redt1de/CarCANdy/DOC/teensy-4.1-pinout.webp

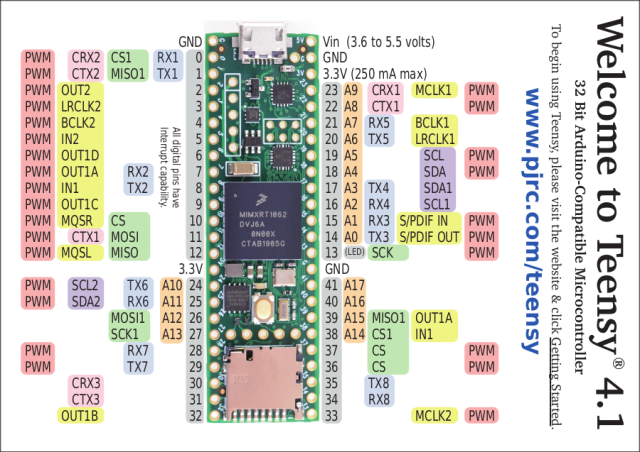
DOC/teensy-4.1-pinout.webp
