redt1de/CarCANdy/Hardware/CarCANdy-PCB/DOC/esp32-can-shield-v1.3b-all-parts-e1739144618402.png

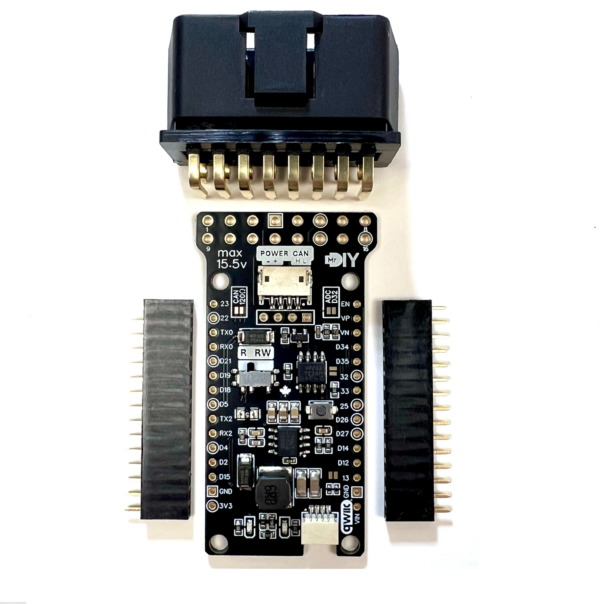
Hardware/CarCANdy-PCB/DOC/esp32-can-shield-v1.3b-all-parts-e1739144618402.png
