redt1de/CarCANdy/DOC/README.md

# DOC

Project notes, wiring, and design references.

- [architecture.md](architecture.md) — component/data-flow overview
- [pinout.md](pinout.md) — wiring/pinout reference (fill in against actual build)
- [protocol.md](protocol.md) — Teensy <-> ESP32 wire protocol (`Firmware/Shared/Packet.h`)
- [open-risks.md](open-risks.md) — known unresolved technical risks
- [config.example.json](config.example.json) — reference Teensy config schema
