redt1de/CarCANdy/DOC/protocol.md

# Teensy <-> ESP32 Protocol

Defined in [`Firmware/Shared/Packet.h`](../Firmware/Shared/Packet.h) and
[`Firmware/Shared/CanTypes.h`](../Firmware/Shared/CanTypes.h).

## Frame format

```
[sync: uint8 = 0xAA][type: uint8][length: uint16][payload: uint8[length]][crc8: uint8]
```

`crc8` is computed over `type + length + payload[0..length)`.

## Message types (`MsgType`)

| Type | Direction | Purpose |
|---|---|---|
| PING | either | liveness check |
| ACK / NACK  | either | acknowledge / reject a prior message |
| CMD | ESP32 -> Teensy  | generic command -- currently used for filter control (see below); ACK/NACK reply |
| CONFIG_GET  | ESP32 -> Teensy  | request current config |
| CONFIG_SET  | ESP32 -> Teensy  | apply new config (JSON bytes as payload) |
| CONFIG_DATA | Teensy -> ESP32  | config JSON bytes, reply to CONFIG_GET |
| CAN_FRAME | either | Teensy -> ESP32: a frame received off the bus. ESP32 -> Teensy: a frame to transmit, subject to `CANManager::sendFrame()`'s per-bus enabled/mode check (ACK/NACK reply) |
| LOG_LINE | Teensy -> ESP32  | one line of Logging's non-CAN-frame output, for the WebUI's Logging page |
| STATUS | Teensy -> ESP32  | periodic health/status blob (`CarCANdy::StatusInfo` in `Firmware/Shared/CanTypes.h`), currently just `sdReady` |

The Teensy-side dispatch lives in `Firmware/Teensy/src/CommManager.cpp`. The ESP32
side (`Firmware/ESP32/src/CommManager.cpp`) sends `CONFIG_GET` on a retry loop until
the Teensy answers (caching the JSON for `GET /api/config`), forwards
`POST /api/config` as `CONFIG_SET` and `POST /api/can/send` as a `CAN_FRAME`
transmit request (both fire-and-forget -- see below), and forwards inbound
`CAN_FRAME`/`LOG_LINE` out to WebSocket clients via callbacks. `STATUS` is
sent by `Firmware/Teensy/src/CommManager.cpp::sendStatus()` every 2s once its
`CommClient` is up; the ESP32 side just caches the latest value (no history)
and serves it via `GET /api/status`.

`LOG_LINE` is produced by `Logging::write()` (Teensy) calling a line
callback wired up in `Firmware/Teensy/src/main.cpp` -- every complete
print()/println()/printf() call Logging makes gets forwarded this way
(mirroring whatever would also go to `/log/debug_NN.log` if debug logging is
enabled on SD, but independent of that setting -- this stream works even
with SD debug logging off). `logCanFrame()` deliberately bypasses `write()`
so CAN frames are never sent as LOG_LINE packets.

### CMD grammar

`CMD`'s payload is an ASCII string (case-sensitive), parsed by
`Firmware/Teensy/src/CommManager.cpp::handleCmd()`. Currently used entirely for
filter control (see `Firmware/Teensy/include/FilterManager.h` and the filtering
design discussion):

| Command | Effect |
|---|---|
| `RELOAD_FILTERS` | Re-reads the filter CSV from SD (picks up hand-edits without a reflash) |
| `SET_FILTER_OVERRIDE:<mode>` | `mode` = `allow`\|`deny`\|`none`\|`clear`. Runtime-only, **not** persisted to `config.json` -- `clear` reverts to the configured mode. This is what the WebUI Sniffer tab's "show everything" toggle uses, so you can temporarily see unfiltered traffic without touching the saved filter mode. |
| `ADD_FILTER:<bus>,<id>` or `<bus>,<idStart>-<idEnd>` | Adds an entry and persists it to the filter CSV immediately |
| `REMOVE_FILTER:<bus>,<id>` or `<bus>,<idStart>-<idEnd>` | Removes a matching entry and persists the change |

IDs may be decimal or `0x`-prefixed hex. The ESP32 forwards these verbatim
via `CommManager::sendCmd()` / `POST /api/cmd` (`{"cmd": "..."}`) -- it has
no idea what the strings mean, it's purely a passthrough.

### Fire-and-forget requests (no reply correlation yet)

Neither side's protocol includes a request ID, so `sendConfigSet()` and
`sendCanFrame()` on the ESP32 don't wait for or correlate the Teensy's
ACK/NACK back to the HTTP request that triggered them -- the HTTP response
just confirms the packet was queued for send, not that the Teensy accepted
it. For `CONFIG_SET`, the ESP32 re-requests `CONFIG_GET` ~500ms later so
`GET /api/config` catches up either way. A NACK (e.g. a rejected transmit
because the target bus is `read_only`) is logged on the ESP32's debug
`Serial` (USB)
but not (yet) surfaced back to the web client -- worth adding request IDs
and a real response if that silence turns out to be confusing in practice.

## Transport-specific framing notes

- **UART** is a continuous byte stream. The receiver must scan for `sync`,
  tentatively read `type` + `length`, then validate `crc8` before trusting the
  frame — `0xAA` can legitimately appear inside real CAN payload bytes, so a
  single matching sync byte is not proof of a real frame boundary (false-sync
  risk). `CarCANdy::PacketStreamParser` (in `Firmware/Shared/Packet.h`) implements this
  as a byte-at-a-time state machine: on a CRC mismatch it resets to scanning
  for the next sync byte rather than assuming the whole link desynced. Both
  the Teensy's and the ESP32's `UARTClient` feed it and queue up to 8
  completed packets so a burst arriving between `poll()` calls isn't dropped
  (a 9th packet before `CommManager` drains the queue is dropped and logged;
  neither side retries on a dropped/missing reply yet, since there's no
  request ID to retry against -- see the fire-and-forget note below).
- **SPI** is paused by choice for now (UART is fast enough so far -- see
  [open-risks.md](open-risks.md) #1); when it resumes: transaction-based, the
  ESP32 (master) initiates fixed-size transfers, so there's no
  continuous-stream resync problem — `length` just says how much of the
  transfer is valid payload. The Teensy (slave) uses a dedicated DRDY GPIO
  line to tell the ESP32 when a frame is queued, since SPI slaves cannot push
  data unsolicited.

## Known limitation

`PACKET_MAX_PAYLOAD` is 1024 bytes (bumped from 512 once the config schema's
actual size, ~505 bytes with the current plugin set, left the old limit
almost no headroom — see `DOC/config.example.json`). If the config schema
grows a lot further (many more plugins/settings), it could still exceed
this — see [open-risks.md](open-risks.md) for that discussion and the
other options considered (fragmentation, section-scoped config requests,
MessagePack). `ConfigManager::toJson()`/`CommManager` treat "doesn't fit"
as an explicit failure (NACK) rather than corrupting data, but real
fragmentation/chunking across multiple packets is still not implemented.

## Endianness / struct layout

Both Teensy 4.1 (Cortex-M7) and ESP32 (Xtensa LX6) are little-endian
GCC-based toolchains, and all wire structs use `#pragma pack(push, 1)`, so raw
struct-to-struct memcpy across the link is safe. This assumption would break
if a big-endian target were ever added to the project.
