redt1de/CarCANdy/CarCANdy-PCB/DOC/notes.md

D1  - reverse-polarity protection use SS16 / SS26 / B160 / B260 Schottky -> SS26 — 2A, 60V Schottky
D2 - flyback diode, use B340A Shottky diode

The RS pin (pin 8) on the SN65HVD233 CAN transceiver selects between three operating modes:
 - High-Speed Mode: Tie to ground (0 V) for maximum transmission speed with no slew-rate limits.
 - Slope Control: Connect a resistor to ground (e.g., 10 kΩ to 100 kΩ) to limit signal rise/fall times, reducing electromagnetic interference (EMI).
 - Standby Mode: Apply a high logic level (near \(V_{CC}\)) to enter a low-current state; the transmitter turns off, but the receiver remains active to detect bus wake-up
