redt1de/CarCANdy/DOC/CAN_RESEARCH/CAN.md

I would like to create a JSON file that will act as a database I can use to lookup/track CAN IDs and values specific to my 2015 Ford Mustang GT. I will eventually make use of this data in CarCANDY but for now I just want to create the database. Please analyze the following sources and organize all the can ids in a way that can be used to decode data logged with CarCANdy. I created a new folder ./DOC/CANDB where we can store various databases for different cars. For now lets just create one for my 2015 Ford Mustang GT

# forum post has a table with some CAN ID information
https://www.mustang6g.com/forums/threads/some-results-of-can-research.176383/

# github projects with CAN IDs for a 2015 ford mutang
https://github.com/v-ivanyshyn/parse_can_logs/blob/master/Ford%20CAN%20IDs%20Summary.md
https://github.com/EricTurner3/s550-canbus/blob/master/database.md
