redt1de/CarCANdy/CarCANdy-PCB-v2/DOC/esp32-can-shield-v1.3b-front-e1739144674632.png

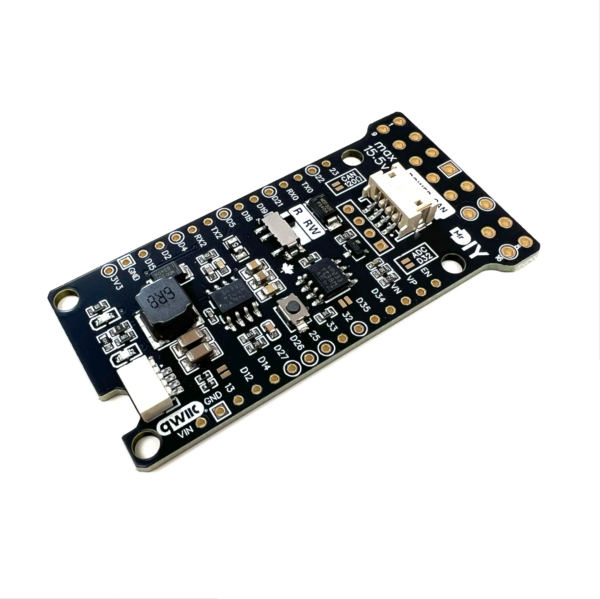
CarCANdy-PCB-v2/DOC/esp32-can-shield-v1.3b-front-e1739144674632.png
