redt1de/CarCANdy/CarCANdy-PCB-v2/DOC/pcb_can_shield_esp32_v1.1.png

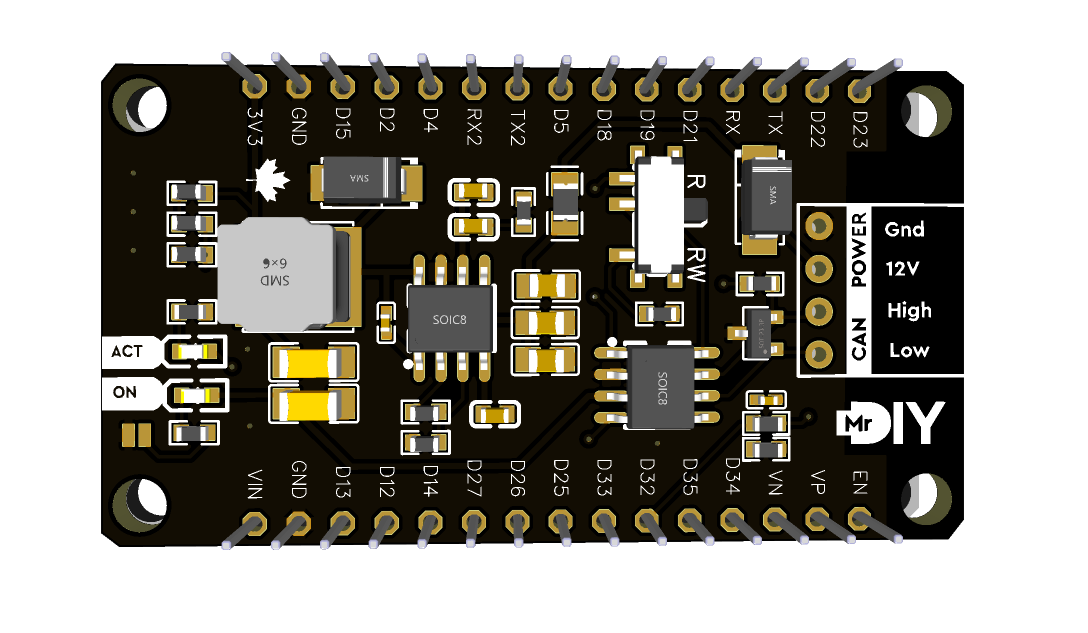
CarCANdy-PCB-v2/DOC/pcb_can_shield_esp32_v1.1.png
