redt1de/CarCANdy/DOC/ESP32-S3-Mini_pinout.jpg

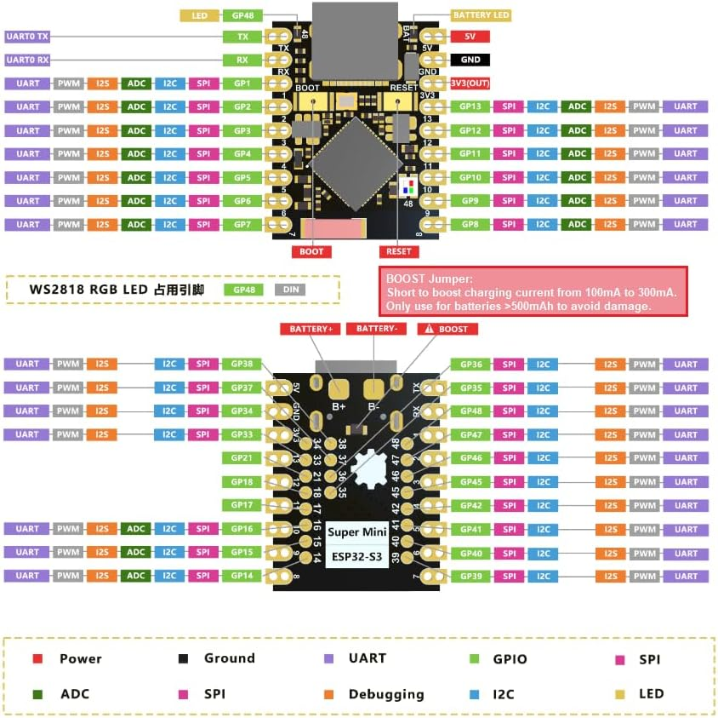
DOC/ESP32-S3-Mini_pinout.jpg
