redt1de/CarCANdy/DOC/RJ45-Pinout-T568A.jpg

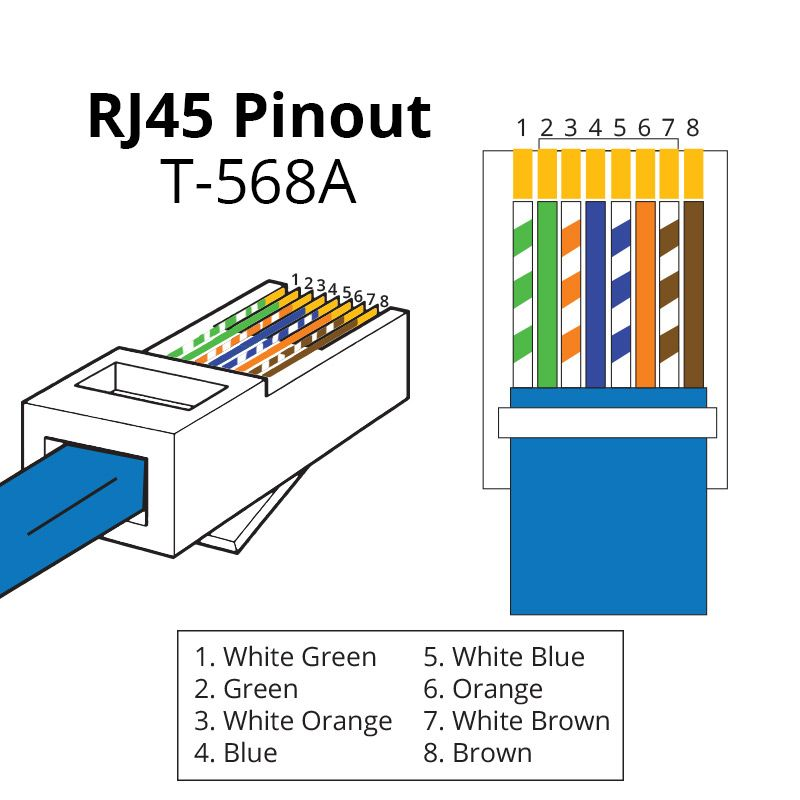
DOC/RJ45-Pinout-T568A.jpg
