redt1de/CarCANdy/Hardware/CarCANdy-PCB/DOC/pcb-io-backup.png

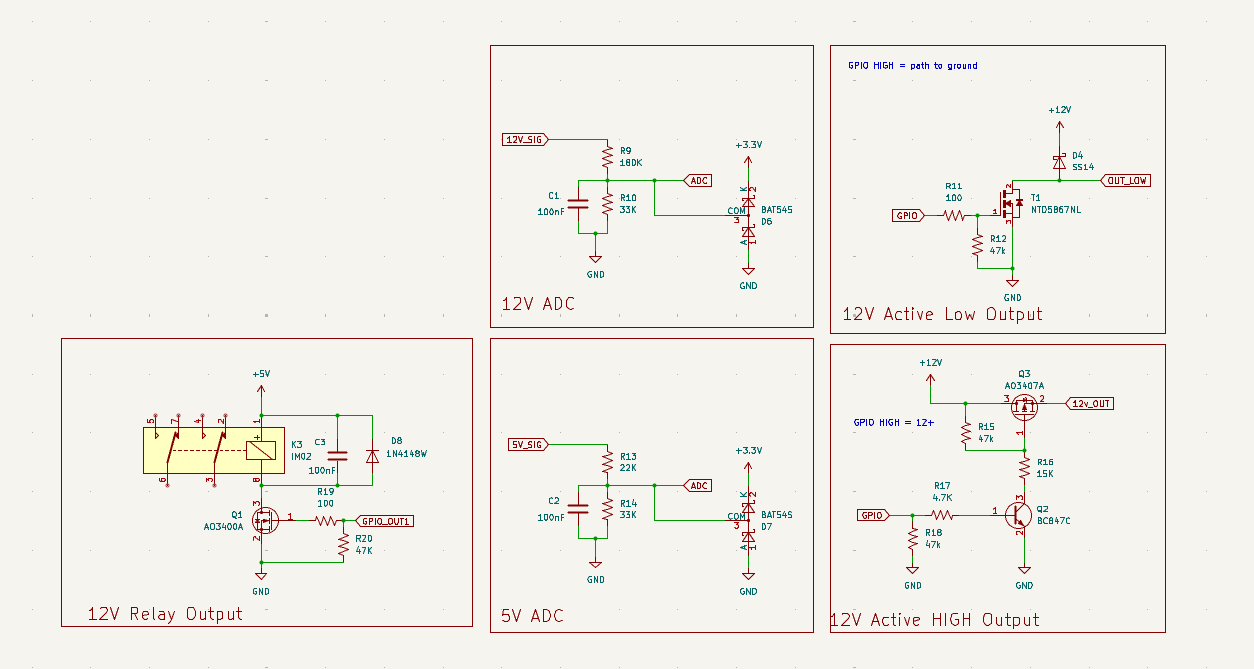
Hardware/CarCANdy-PCB/DOC/pcb-io-backup.png
