redt1de/CarCANdy/CarCANdy-PCB/shopping-list.txt

# ICs
*x3 NUP2105LT1G SOT23-3
*x6 1N4148W D_SOD-123
*x2 BAT54S SOT-23
*x3 SN65HVD233DR SOIC127P599X175-8N
*x3 IM02 RELAY_IM02TS (1-1462038-2 is parametric replacement, non bulk)
*x3 AO3400A SOT-23
*x3 LTV-357T 4-SOP
*x3 JS202011CQN JS202011CQN (digikey alternative CL-SB-22C-02 cause its 12V)

# Connectors
!x1 8P8C_Shielded RJ45_RCH_RC01937 (https://www.amazon.com/FMHXG-Shielded-Network-Connector-Computer/dp/B0BRQ2R8HW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)
!x1 Power JST_VH_S2P-VH_1x02_P3.96mm_Horizontal (https://www.amazon.com/pzsmocn-JST-VH-SMT-Housing-Connector-Terminal/dp/B089QR8G2D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)
!x3 Relays JST_VH_S3P-VH_1x03_P3.96mm_Horizontal (https://www.amazon.com/pzsmocn-JST-VH-SMT-Housing-Connector-Terminal/dp/B08F53M49D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)
!x6 3-pin 2.00mm pitch pin headers with jumpers (amazon)
!x2 Aux JST_PH_S4B-PH-K_1x04_P2.00mm_Horizontal  (https://www.amazon.com/Socket-Compatible-JST-PH-Connectors-Through-Hole/dp/B0BM492MMF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)
!x2 ADCs JST_EH_S3B-EH_1x03_P2.50mm_Horizontal (https://www.amazon.com/sspa/click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)
!x3 Inputs JST_EH_S2B-EH_1x02_P2.50mm_Horizontal (^^ above kit ^^)

# Caps and Resistors
x3 120 R_0603_1608Metric_Pad0.98x0.95mm_HandSolder
x3 10K R_0603_1608Metric_Pad0.98x0.95mm_HandSolder
x3 2.2K R_0603_1608Metric_Pad0.98x0.95mm_HandSolder
x3 10k R_0603_1608Metric_Pad0.98x0.95mm_HandSolder
x2 22K R_0603_1608Metric_Pad0.98x0.95mm_HandSolder
x2 33K R_0603_1608Metric_Pad0.98x0.95mm_HandSolder
x3 100 R_0603_1608Metric_Pad0.98x0.95mm_HandSolder
x3 47K R_0603_1608Metric_Pad0.98x0.95mm_HandSolder
x5 100nF 0603 Capacitor (https://www.amazon.com/Cermant-Capacitor-Assorted-3-9pF-22uF-Electronic/dp/B09V9XH6YL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)

# Misc
*x1 ESP32-C3_SUPERMINI_TH MODULE_ESP32-C3_SUPERMINI_TH (amazon)
*x1 Teensy4.1 Teensy41 (amazon)
*x1 12v-5v_mini_buck mini12v-5v_buck (amazon)

x -0.018
y -0.629
