redt1de/CarCANdy/DOC/parts.md

NTD5867NLT4G - MOSFET
sn65hvd233 - CAN Transiever
nup2105lt1g - TVS Diode
1-1462038-6/IM06 - Relay
100nF Capacitor
LTV-817S-TA - optocoupler
