redt1de/CarCANdy/Hardware/CarCANdy-PCB/pcbway_production/2026-07-21-17-01-40/CarCANdy-PCB.kicad_pcb_bom.csv

Designator | Quantity | Value | Footprint | Package | MPN | DNP | Mount_Type | Description | KiLib_Generator | MF | MAXIMUM_PACKAGE_HEIGHT | Price | Check_prices | STANDARD | PARTREV | SnapEDA_Link | MP | MANUFACTURER | Availability | SNAPEDA_PN | Sim.Device | Sim.Pins | CREATOR
C2, C3, C4, C5, C6 | 5 | 100nF | C_0603_1608Metric_Pad1.08x0.95mm_HandSolder |  |  |  | smt | Unpolarized capacitor | SMD_2terminal_chip_molded
D1, D2, D3 | 3 | NUP2105LT1G | SOT-23-3 | SOT-23-3 ON Semiconductor |  |  | smt | Dual Bi-Directional TVS Diode 350W 3-Pin SOT-23 | ON Semiconductor NUP2105LT1G | package/gullwing | ON Semiconductor | 1.11mm | None | https://www.snapeda.com/parts/NUP2105LT1G/Onsemi/view-part/?ref=eda | IPC-7351B | 10 | https://www.snapeda.com/parts/NUP2105LT1G/Onsemi/view-part/?ref=snap | NUP2105LT1G | Onsemi | In Stock | NUP2105LT1G
D10, D11, D12, D5, D8, D9 | 6 | 1N4148W | D_SOD-123 |  |  |  | smt | 75V 0.15A Fast Switching Diode, SOD-123 |  |  |  |  |  |  |  |  |  |  |  |  | D | 1=K 2=A
D13, D7 | 2 | BAT54S | SOT-23 |  |  |  | smt | Vr 30V, If 200mA, Dual schottky barrier diode, in series, SOT-323 | package/gullwing
J1 | 1 | 8P8C_Shielded | RJ45_RCH_RC01937 |  |  |  | tht | RJ connector, 8P8C (8 positions 8 connected), RJ31/RJ32/RJ33/RJ34/RJ35/RJ41/RJ45/RJ49/RJ61, Shielded
J10, J11 | 2 | ADC1 | JST_XH_S3B-XH-A-1_1x03_P2.50mm_Horizontal |  |  |  | tht | Generic connector, single row, 01x03, script generated | connector/JST
J13, J14, J15 | 3 | Conn_01x02_Pin | JST_XH_S2B-XH-A-1_1x02_P2.50mm_Horizontal |  |  |  | tht | Generic connector, single row, 01x02, script generated | connector/JST
J2 | 1 | Power | JST_VH_S2P-VH_1x02_P3.96mm_Horizontal |  |  |  | tht | Generic connector, single row, 01x02, script generated | connector/JST
J4, J8 | 2 | AUART1 | JST_XH_S4B-XH-A-1_1x04_P2.50mm_Horizontal |  |  |  | tht | Generic connector, single row, 01x04, script generated | connector/JST
J5, J6, J7 | 3 | JSTVH3 | JST_VH_S3P-VH_1x03_P3.96mm_Horizontal | None |  |  | tht | 2~24 Poles, Screw Type, Horizontal, 5.08 Pitch, 24~12 (AWG), Terminal Block Connector | connector/JST | Same Sky |  | None | https://www.snapeda.com/parts/TB004-508-03BE/Same+Sky/view-part/?ref=eda | Manufacturer Recommendations |  | https://www.snapeda.com/parts/TB004-508-03BE/Same+Sky/view-part/?ref=snap | TB004-508-03BE | CUI | In Stock
K3, K4, K5 | 3 | IM02 | RELAY_IM06TS |  |  |  | tht | IM Relay, standard version, monostable, switching current 2/5A, power 60W/62.5VA, voltage 220VDC/250VAC
PSU1 | 1 | 12v-5v_mini_buck | mini12v-5v_buck |  |  |  | smt | Generic connector, single row, 01x04, script generated
Q1, Q2, Q3 | 3 | AO3400A | SOT-23 |  |  |  | smt | 30V Vds, 5.7A Id, N-Channel MOSFET, SOT-23 | package/gullwing
R1, R3, R5 | 3 | 120 | R_0603_1608Metric_Pad0.98x0.95mm_HandSolder |  |  |  | smt | Resistor, US symbol | SMD_2terminal_chip_molded
R13, R15 | 2 | 22K | R_0603_1608Metric_Pad0.98x0.95mm_HandSolder |  |  |  | smt | Resistor, US symbol | SMD_2terminal_chip_molded
R14, R16 | 2 | 33K | R_0603_1608Metric_Pad0.98x0.95mm_HandSolder |  |  |  | smt | Resistor, US symbol | SMD_2terminal_chip_molded
R19, R25, R27 | 3 | 100 | R_0603_1608Metric_Pad0.98x0.95mm_HandSolder |  |  |  | smt | Resistor, US symbol | SMD_2terminal_chip_molded
R2, R4, R6 | 3 | 10K | R_0603_1608Metric_Pad0.98x0.95mm_HandSolder |  |  |  | smt | Resistor, US symbol | SMD_2terminal_chip_molded
R20, R26, R28 | 3 | 47K | R_0603_1608Metric_Pad0.98x0.95mm_HandSolder |  |  |  | smt | Resistor, US symbol | SMD_2terminal_chip_molded
R21, R23, R7 | 3 | 2.2K | R_0603_1608Metric_Pad0.98x0.95mm_HandSolder |  |  |  | smt | Resistor, US symbol | SMD_2terminal_chip_molded
R22, R24, R8 | 3 | 10k | R_0603_1608Metric_Pad0.98x0.95mm_HandSolder |  |  |  | smt | Resistor, US symbol | SMD_2terminal_chip_molded
SW2, SW3, SW4 | 3 | JS202011CQN | JS202011CQN |  |  |  | tht | Switch, dual pole double throw, separate symbols
U1, U7, U8 | 3 | LTV-357T | SOP-4_3.8x4.1mm_P2.54mm |  |  |  | smt | DC Optocoupler, Vce 35V, CTR 50%, SO-4 | package/gullwing
U2 | 1 | ESP32-C3_SUPERMINI_TH | MODULE_ESP32-C3_SUPERMINI_TH | Package |  |  | tht | Super tiny ESP32-C3 board |  | Espressif Systems |  | None | https://www.snapeda.com/parts/ESP32-C3%20SuperMini_TH/Espressif+Systems/view-part/?ref=eda | IPC-7351B |  | https://www.snapeda.com/parts/ESP32-C3%20SuperMini_TH/Espressif+Systems/view-part/?ref=snap | ESP32-C3 SuperMini_TH | Espressif Systems | Not in stock |  |  |  | DIZAR
U3, U4, U5 | 3 | SN65HVD233DR | SOIC127P599X175-8N | SOIC-8 Texas Instruments |  |  | smt | 3.3 V CAN Transceiver with Standby Mode, Loopback |  | Texas Instruments |  | None | https://www.snapeda.com/parts/SN65HVD233DR/Texas+Instruments/view-part/?ref=eda |  |  | https://www.snapeda.com/parts/SN65HVD233DR/Texas+Instruments/view-part/?ref=snap | SN65HVD233DR |  | In Stock
U6 | 1 | Teensy4.1 | Teensy41 |  |  |  | tht
