redt1de/CarCANdy/Hardware/CarCANdy-PCB/digikey-cart.csv

Index | Quantity | Part Number | Manufacturer Part Number | Description | Customer Reference | Available | Backorder | Unit Price | Extended Price USD
1 | 3 | 296-35967-1-ND | SN65HVD233DR | IC TRANSCEIVER HALF 1/1 8SOIC |  | 3 | 0 | 3.21000 | 9.63
2 | 1 | 160-2038-1-ND | LTV-817S-TA | OPTOISOLATOR 5KV 1CH TRANS 4-SMD |  | 1 | 0 | 0.44000 | 0.44
3 | 3 | NUP2105LT1GOSCT-ND | NUP2105LT1G | TVS DIODE 24VWM 44VC SOT23-3 |  | 3 | 0 | 0.44000 | 1.32
4 | 6 | 1655-1N4148WCT-ND | 1N4148W | DIODE GEN PURP 75V 250MA SOD123 |  | 6 | 0 | 0.14000 | 0.84
5 | 2 | 4878-BAT54SCT-ND | BAT54S | DIODE ARR SCHOTT 30V 200MA SOT23 |  | 2 | 0 | 0.16000 | 0.32
6 | 3 | PB2111-ND | 1-1462038-2 | RELAY TELECOM DPDT 2A 4.5V |  | 3 | 0 | 4.71000 | 14.13
7 | 3 | 785-1000-1-ND | AO3400A | MOSFET N-CH 30V 5.7A SOT23-3L |  | 3 | 0 | 0.52000 | 1.56
8 | 3 | 160-1339-1-ND | LTV-357T | OPTOISO 3.75KV 1CH TRANS 4-SOP |  | 3 | 0 | 0.43000 | 1.29
9 | 3 | 160-1339-1-ND | LTV-357T | OPTOISO 3.75KV 1CH TRANS 4-SOP |  | 3 | 0 | 0.43000 | 1.29
10 | 3 | 401-2001-ND | JS202011CQN | SWITCH SLIDE DPDT 300MA 6V |  | 3 | 0 | 0.84000 | 2.52
11 | 3 | 563-1347-ND | CL-SB-22C-02 | SWITCH SLIDE DPDT 200MA 12V |  | 3 | 0 | 1.52000 | 4.56
