redt1de/CarCANdy/CarCANdy-PCB-v2/pcb.step

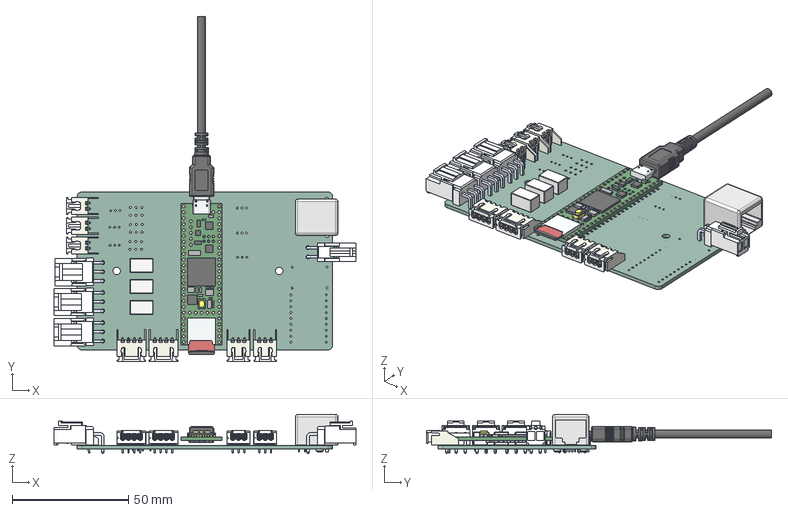
[picture p8: CAD file, 2026-10-16]
CarCANdy-PCB-v2/pcb.step
130.0 x 148.6 x 16.8 mm
JST_S4B_XH_A_1 x 2
Housing x 7
modele_pin x 20
BxPS-VH_3 x 3
pin^BxPS-VH ass x 9
VHR-3N x 3
JST_S3B_XH_A_1 x 2
BxPS-VH_5__Boss-Extrude4
pin^BxPS-VH ass__Chamfer1_2
pin^BxPS-VH ass__Chamfer1
VHR-2N
Teensy_4.1_Assembly
Cable
Micro_USB_Plug_Connector
JST_S2B_XH_A_1 x 3
CarCANdy-PCB-V2_PCB
