redt1de/CarCANdy/Hardware/CarCANdy-PCB/pcb-noplug.step

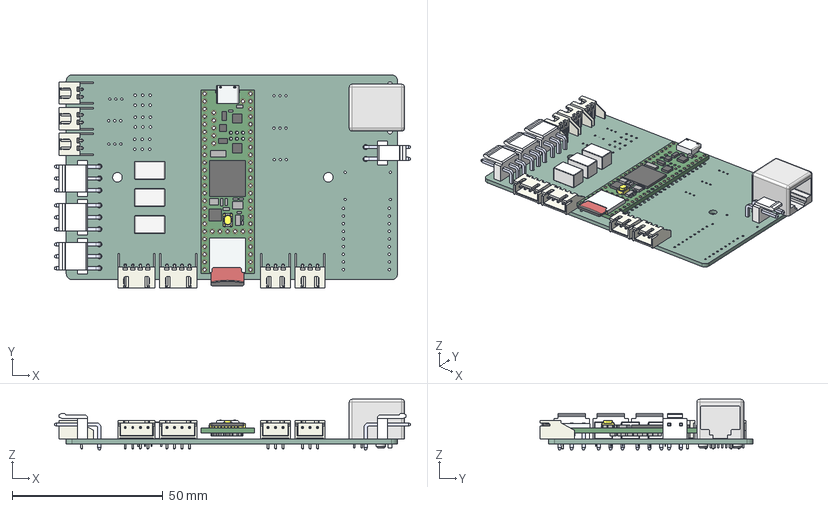
[picture p10: CAD file, 2026-10-17]
Hardware/CarCANdy-PCB/pcb-noplug.step
118.2 x 70.8 x 16.8 mm
JST_S4B_XH_A_1 x 2
BxPS-VH_3 x 3
pin^BxPS-VH ass x 9
JST_S3B_XH_A_1 x 2
BxPS-VH_5__Boss-Extrude4
pin^BxPS-VH ass__Chamfer1_2
pin^BxPS-VH ass__Chamfer1
Teensy_4.1_Assembly
JST_S2B_XH_A_1 x 3
CarCANdy-PCB_PCB
