redt1de/CarCANdy/Hardware/CarCANdy-PCB/pcb-noplug-with-headers.step

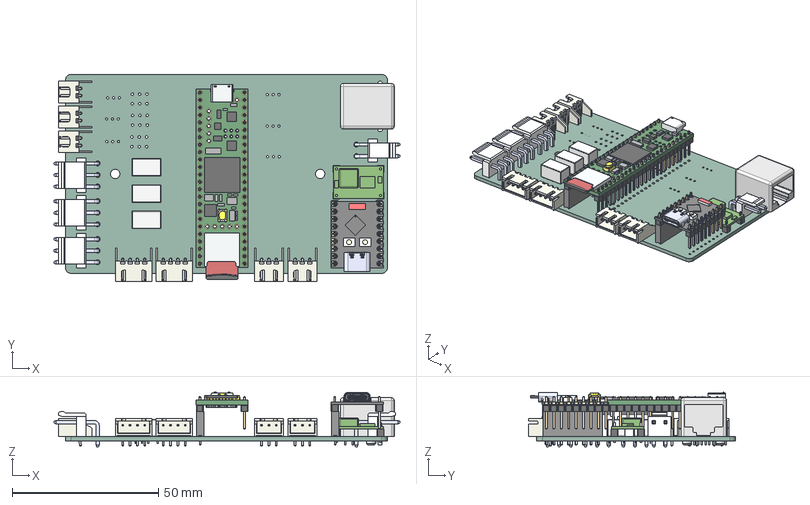
[picture p11: CAD file, 2026-10-17]
Hardware/CarCANdy-PCB/pcb-noplug-with-headers.step
118.2 x 70.8 x 18.7 mm
JST_S4B_XH_A_1 x 2
BxPS-VH_3 x 3
pin^BxPS-VH ass x 9
JST_S3B_XH_A_1 x 2
BxPS-VH_5__Boss-Extrude4
pin^BxPS-VH ass__Chamfer1_2
pin^BxPS-VH ass__Chamfer1
1_Male_Pin_2.54_mm__Chamfer5_7 x 57
FemaleHeader x 2
JST_S2B_XH_A_1 x 3
Board c3mini__Split1[4]
1_Male_Pin_2.54_mm__Chamfer5 x 9
Board c3mini__Split1[6]
Board c3mini__Split1[5]
Board c3mini__Split1[10]
Board c3mini__Split1[2]
Board c3mini__Split1[14]
components (other)^ESP32-C3 SuperMini__Boss-Extrude2
Board c3mini__Split1[7]
Board c3mini__Split1[1]
USB C__Imported1
components (other)^ESP32-C3 SuperMini__Boss-Extrude3[2]
components (other)^ESP32-C3 SuperMini__Boss-Extrude5
Board c3mini__Split1[13]
Board c3mini__Split1[9]
components (other)^ESP32-C3 SuperMini__Cut-Extrude1
components (other)^ESP32-C3 SuperMini__Boss-Extrude3[1]
Board c3mini__Split1[8]
Board c3mini__Split1[12]
Board c3mini__Split1[11]
Board c3mini__Split1[17] x 2
Board c3mini__Split1[16] x 2
components (other)^ESP32-C3 SuperMini__Boss-Extrude4[2]
components (other)^ESP32-C3 SuperMini__Boss-Extrude4[1]
Board c3mini__Split1[3]
Board c3mini__Split1[15]
CarCANdy-PCB_PCB
