redt1de/CarCANdy/CarCANdy-PCB/.step

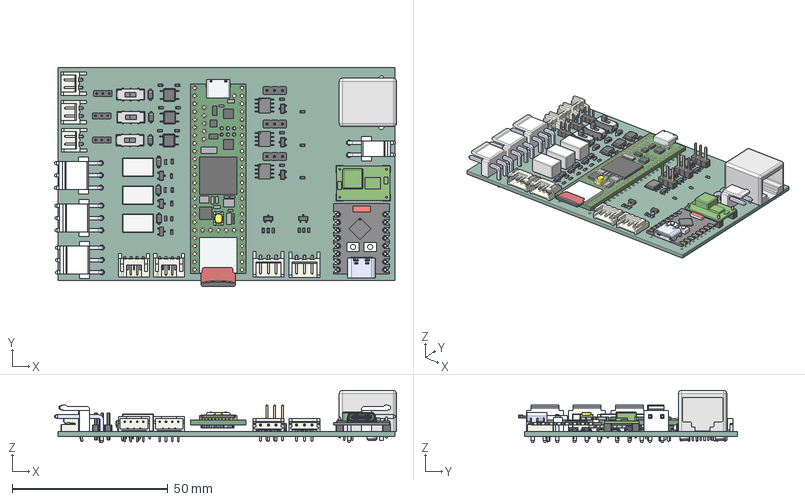
[picture p12: CAD file, 2026-07-21]
CarCANdy-PCB/.step
109.9 x 70.3 x 16.8 mm
R_0603_1608Metric x 22
JST_S4B_PH_K x 2
PinHeader_1x03_P200mm_Vertical x 3
D_SOD-123 x 6
SOT-23 x 5
BxPS-VH_3 x 3
pin^BxPS-VH ass x 9
SOT-23-3 x 3
Body001 (Mirror #1) x 12
XY-plane x 36
X-axis x 36
SOP-4_3.8x4.1mm_P2.54mm x 3
PinHeader_1x03_P254mm_Vertical x 3
JST_S3B_EH x 2
BxPS-VH_5__Boss-Extrude4
pin^BxPS-VH ass__Chamfer1_2
pin^BxPS-VH ass__Chamfer1
Teensy_4.1_Assembly
C_0603_1608Metric x 5
JS202011CQN x 3
JST_S2B_EH x 3
Board c3mini
USB C
components (other)^ESP32-C3 SuperMini
CarCANdy-PCB_PCB
