redt1de/CarCANdy/(list of files, cad)

Other CAD files:
CarCANdy-PCB-v2/pcb-noplug.step
CarCANdy-PCB/pcb.step
CarCANdy-PCB-v2/pcb-noplug-with-headers.step
Hardware/CarCANdy-PCB-v2/CarCANdy-PCB-V2.step
