redt1de/CarCANdy/DOC/claude-TODO.md

Lets clean up the documentation.  
things that need covered:

Hardware:
- teensy pinout
- RJ45 pinout
- aux port pinouts
- input usage (jumpers and switches)
- output usage
- ADC usage
- CAN bus jumpers

Config/Software:
- config.json
- filters.json
