redt1de/CarCANdy/DOC/TODO.md

TODO

## WebUI changes
- sniffer page should have send capabilities.
