redt1de/CarCANdy/CarCANdy-PCB/CarCANdy-PCB.kicad_pcb

## KiCad design CarCANdy-PCB/CarCANdy-PCB.kicad_pcb (2026-08-25)

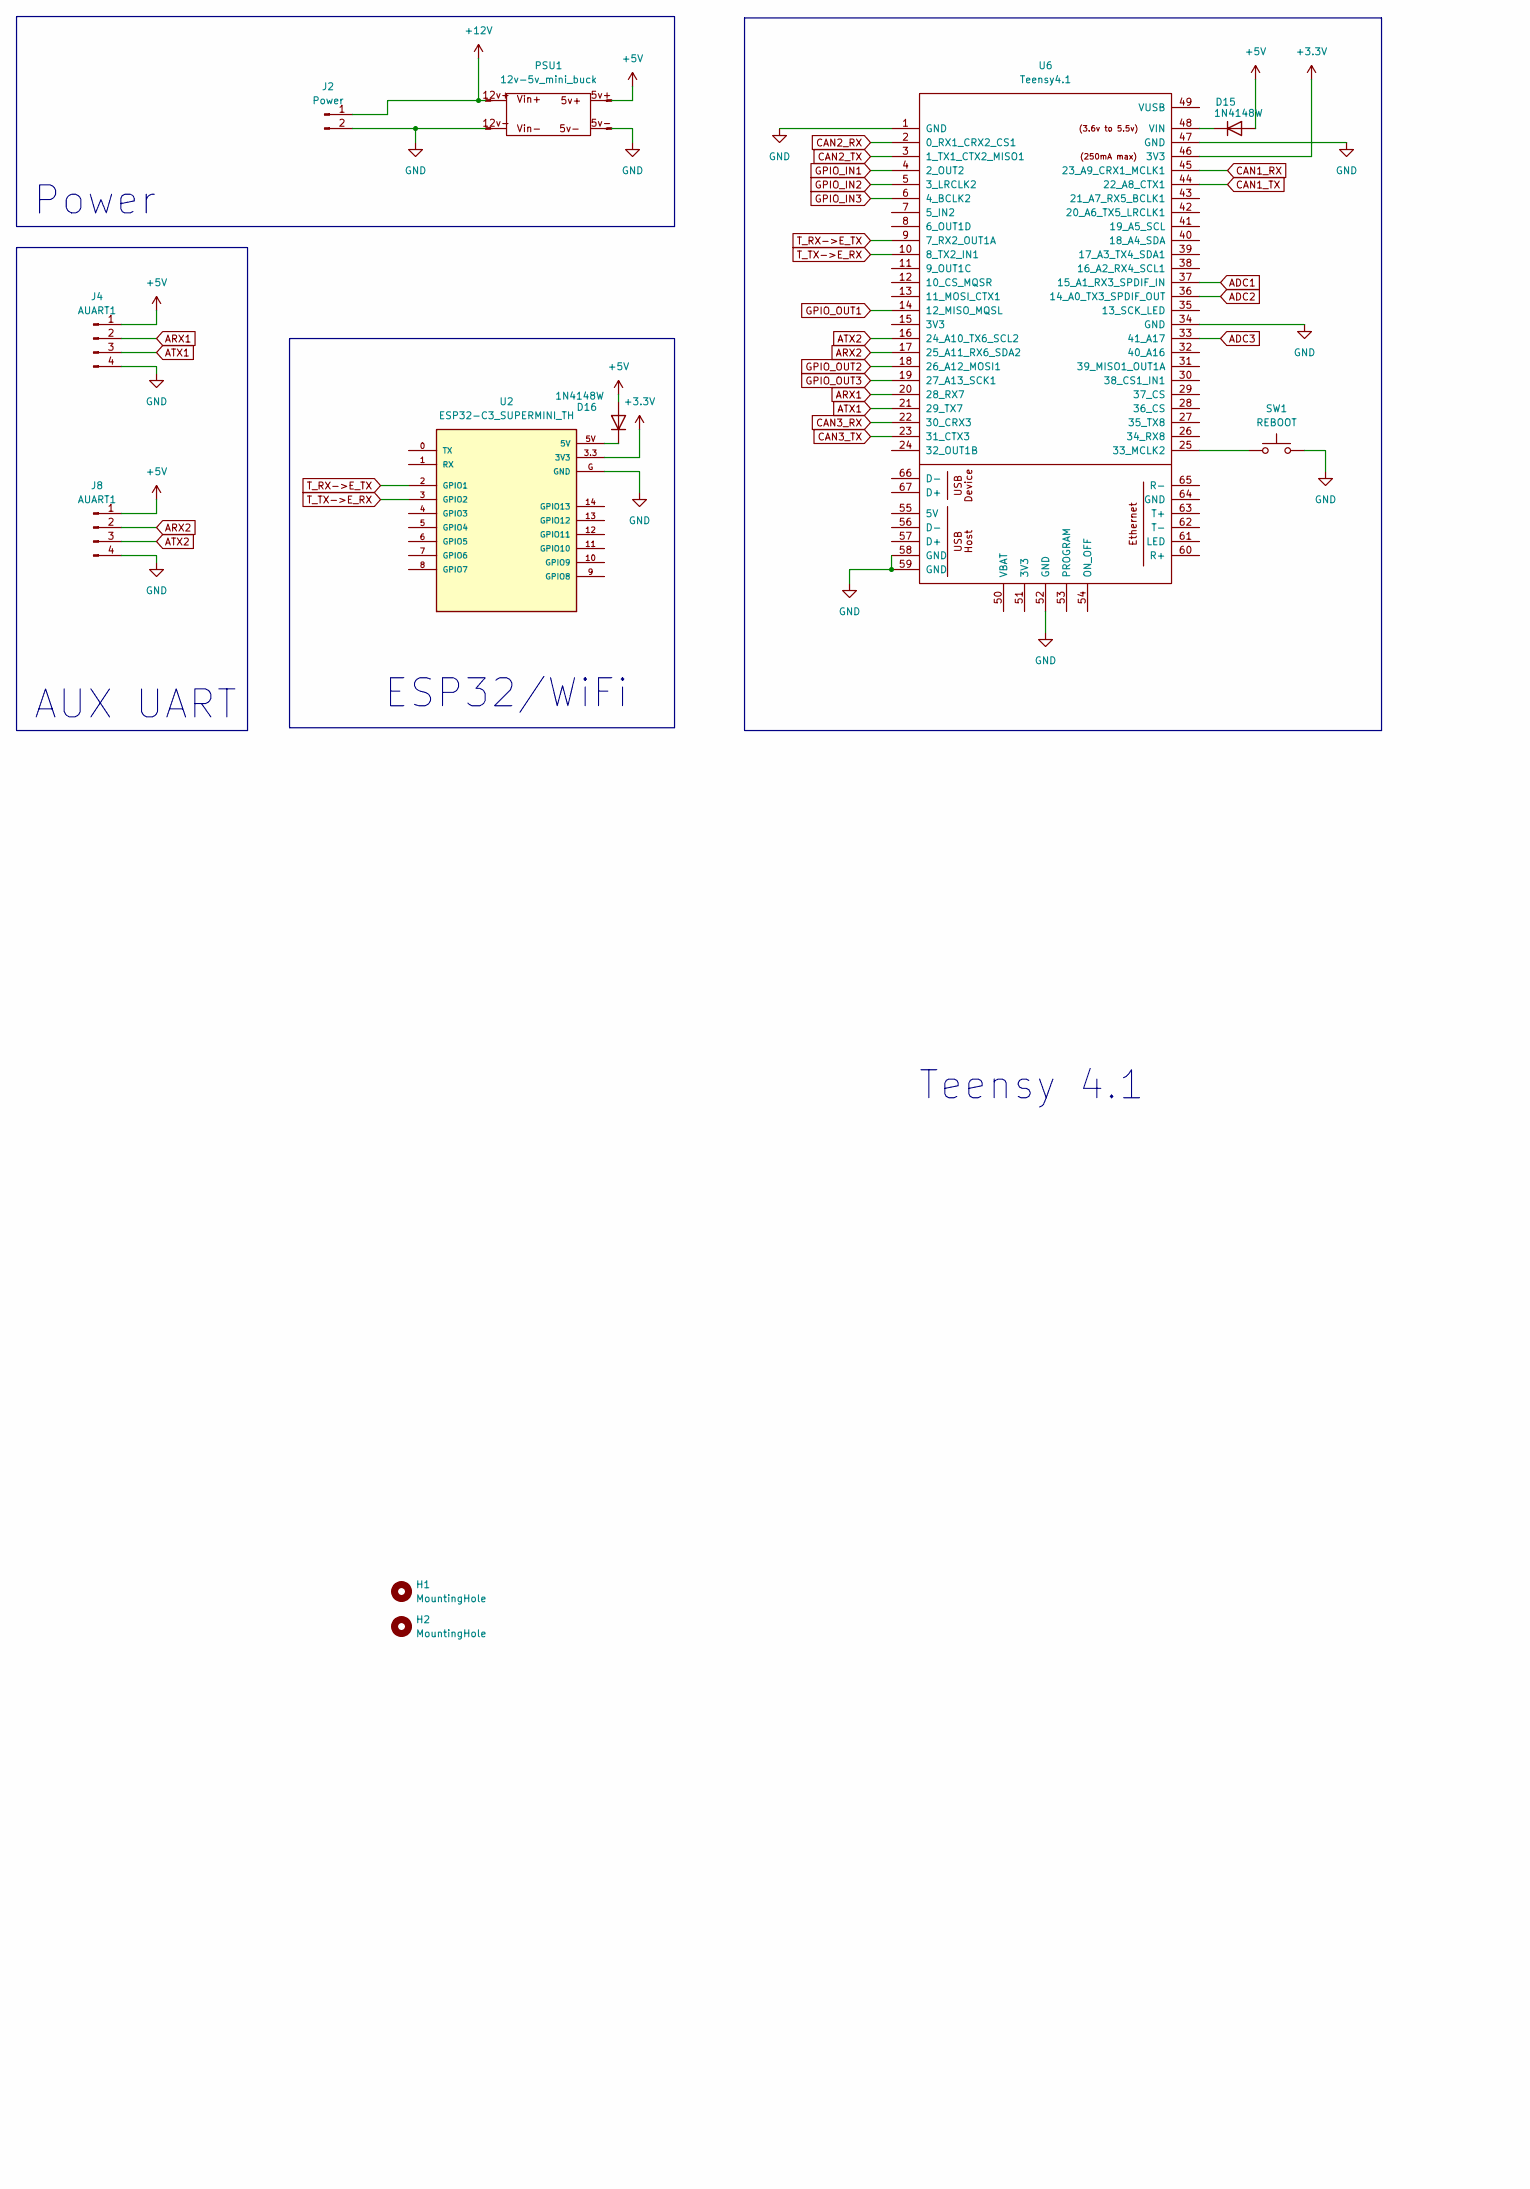
[picture p13: schematic CarCANdy-PCB.kicad_sch, part in row 1, column 1]

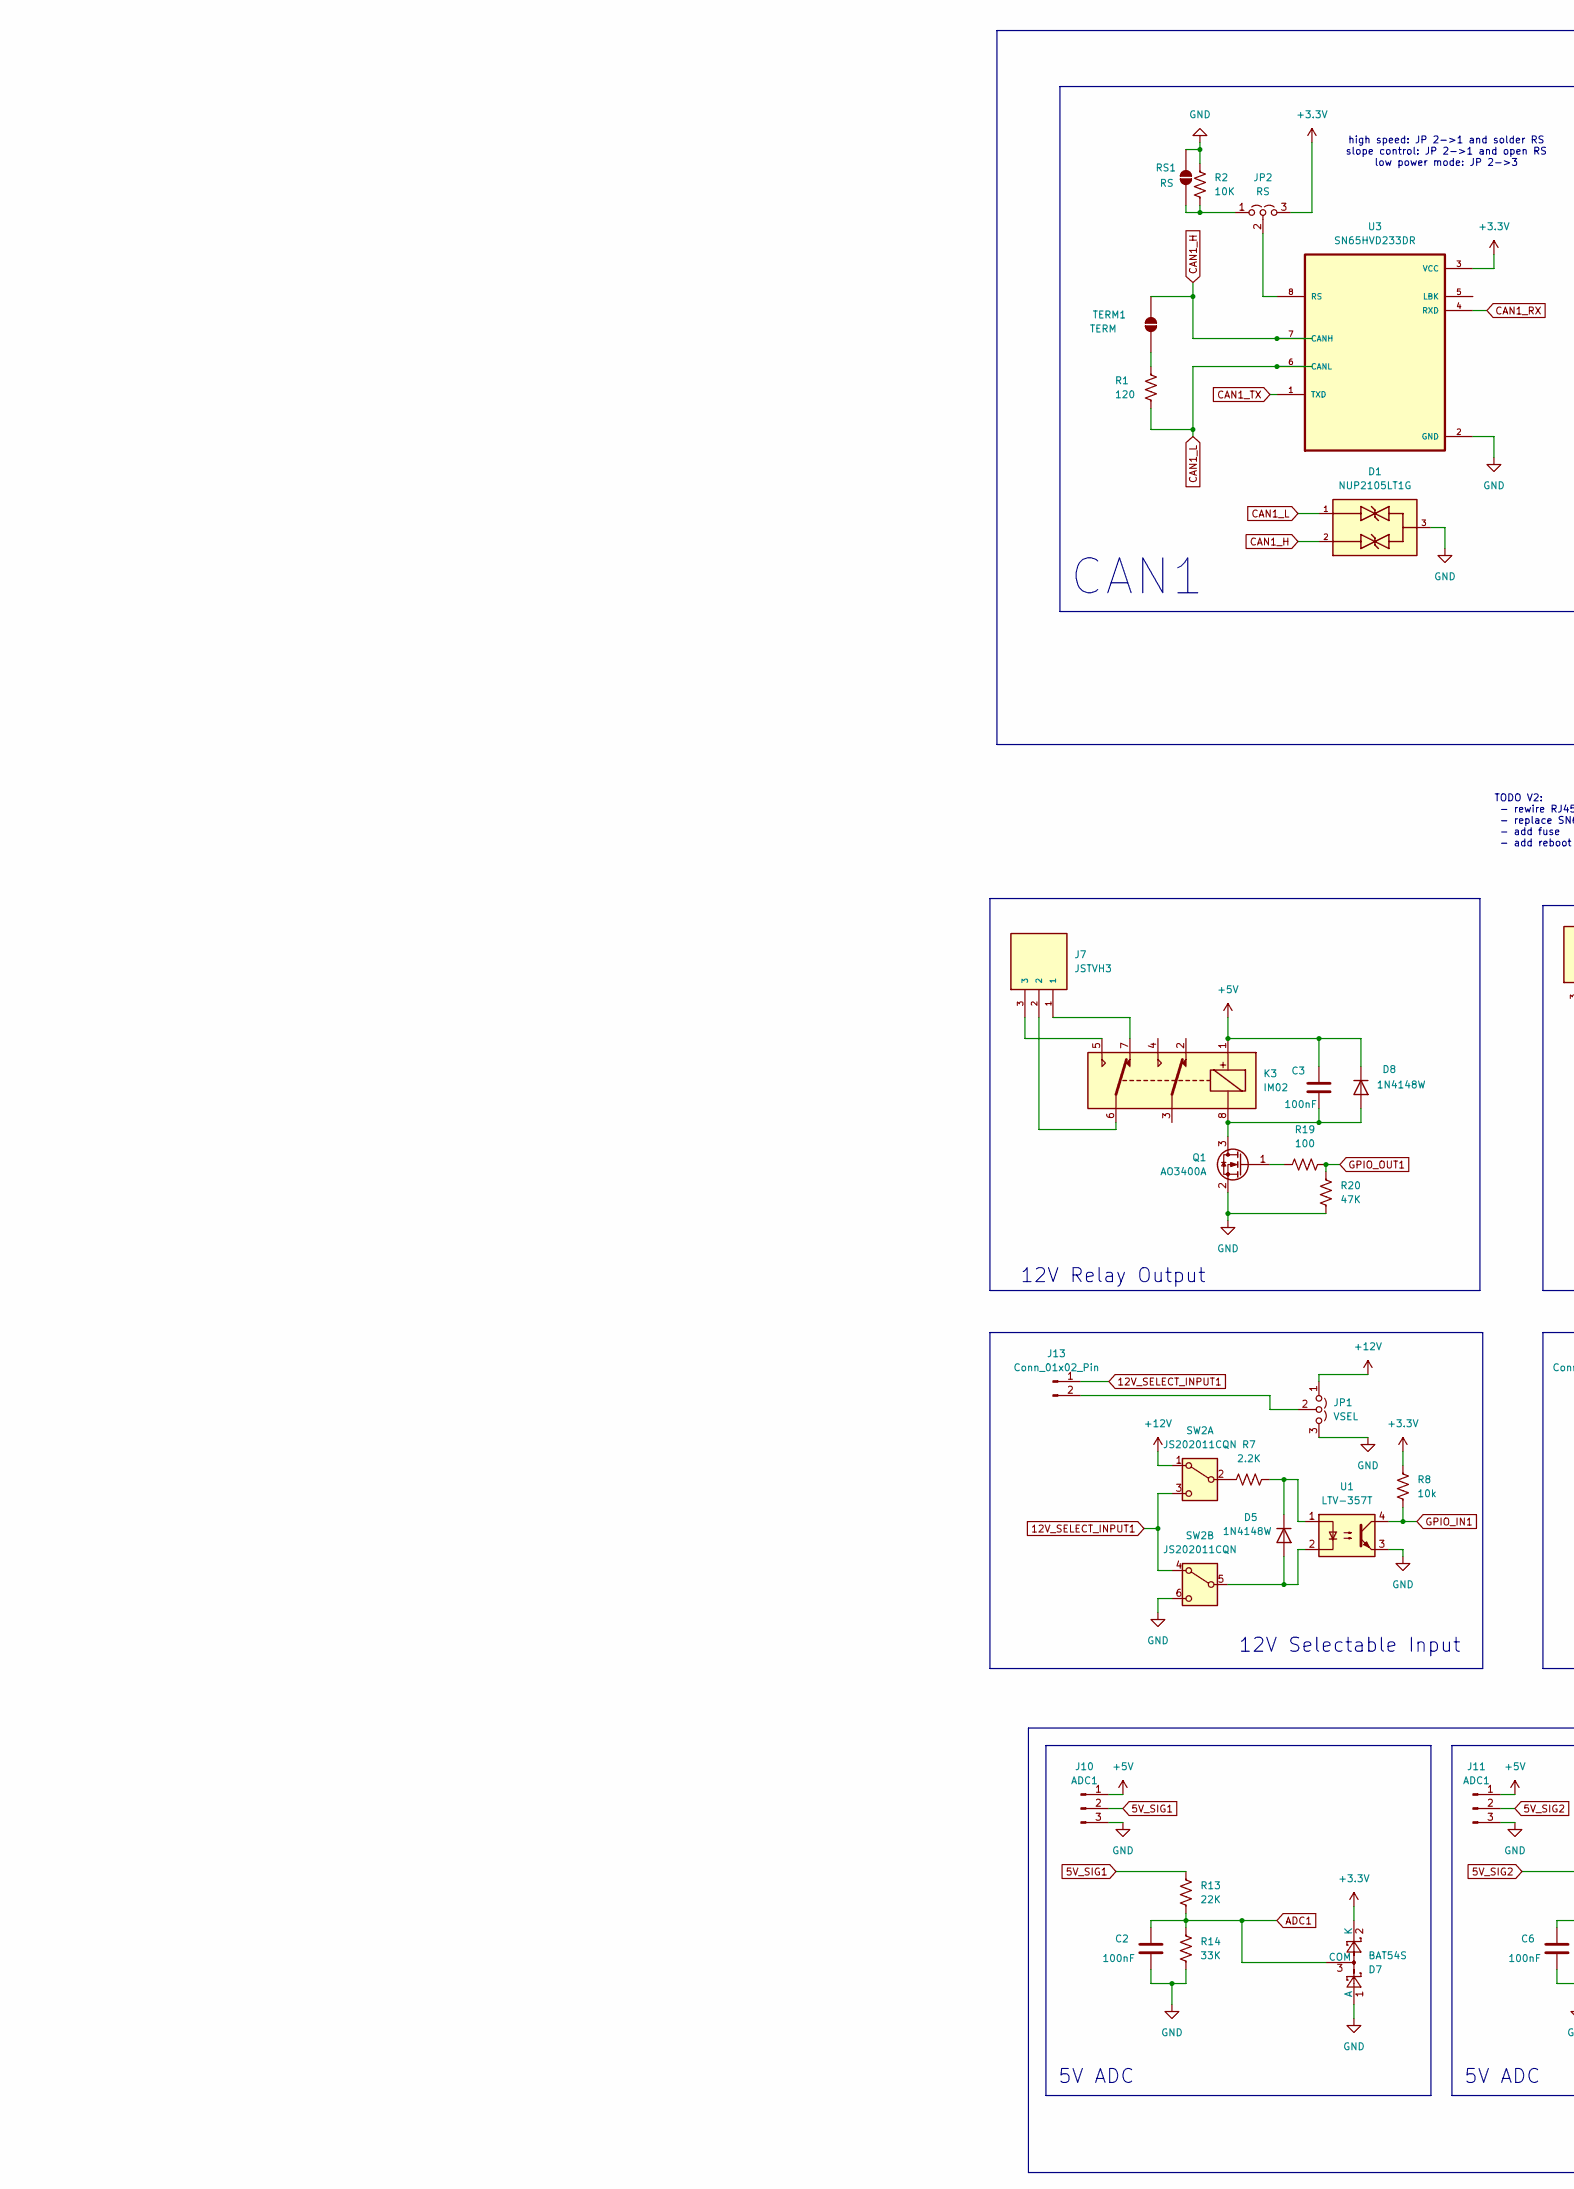
[picture p14: schematic CarCANdy-PCB.kicad_sch, part in row 1, column 2]

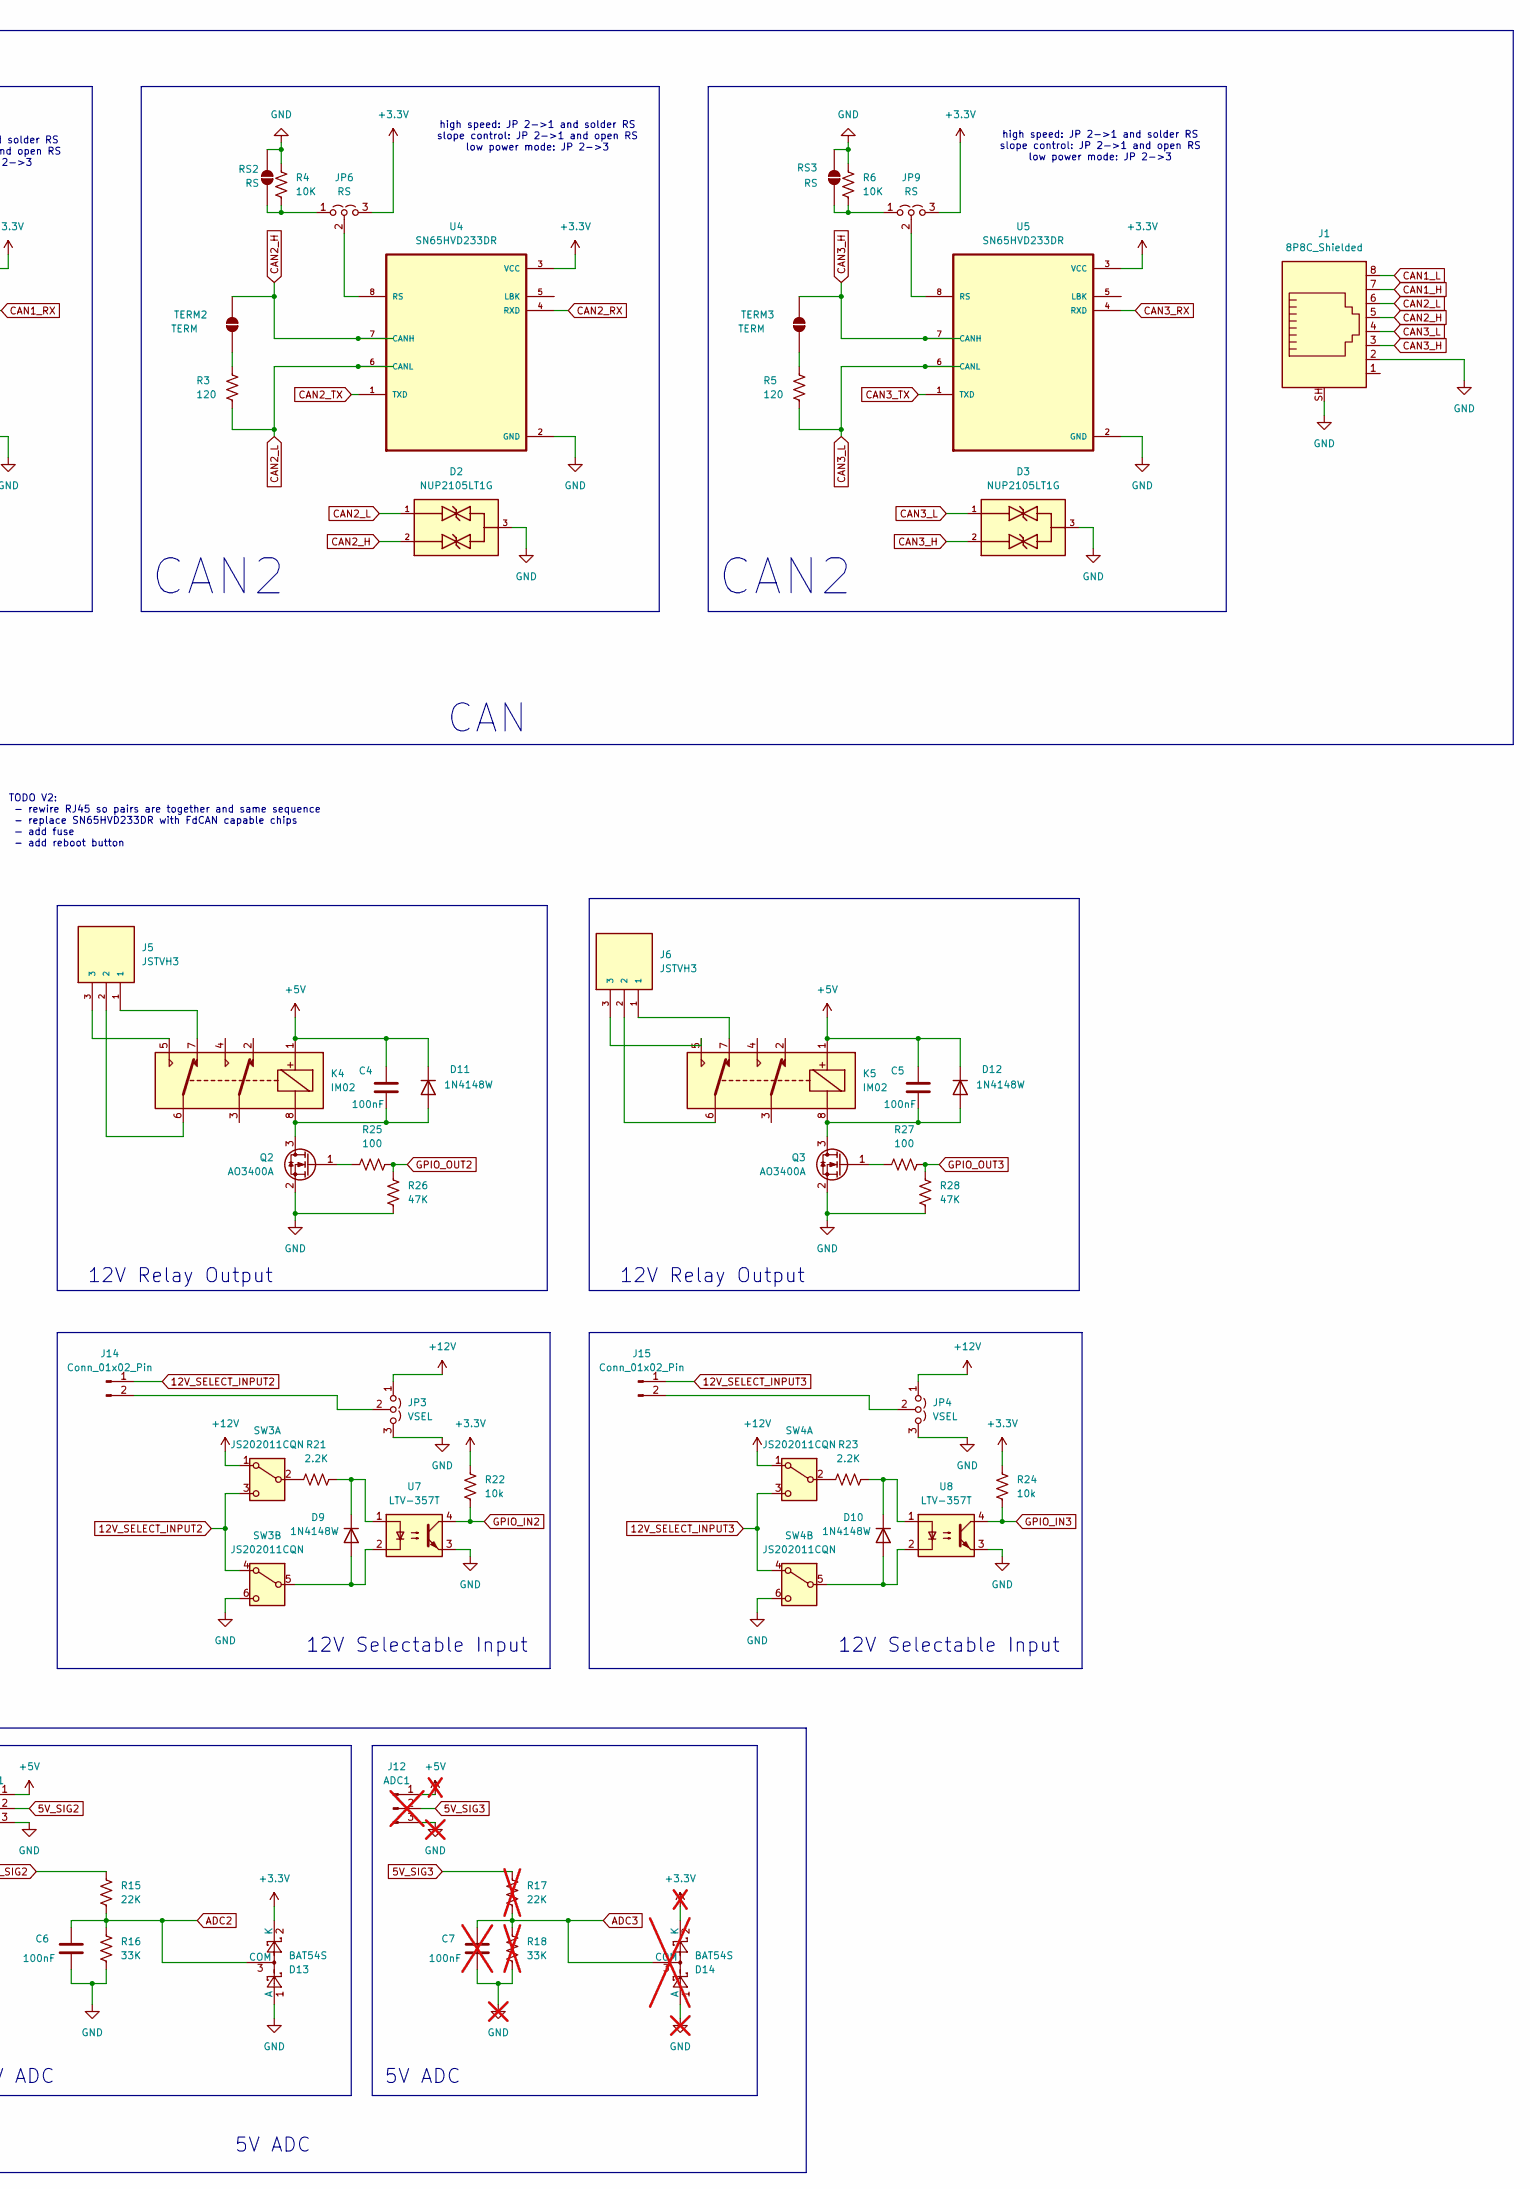
[picture p15: schematic CarCANdy-PCB.kicad_sch, part in row 1, column 3]

Parts:
C2, C3, C4, C5, C6: 100nF; C_1206_3216Metric_Pad1.33x1.80mm_HandSolder
C7: 100nF; C_0603_1608Metric_Pad1.08x0.95mm_HandSolder; not fitted
D1, D2, D3: NUP2105LT1G; SOT-23-3; PARTREV 10
D5, D8, D9, D10, D11, D12, D15, D16: 1N4148W; D_SOD-123
D7, D13: BAT54S; SOT-23
D14: BAT54S; SOT-23; not fitted
H1, H2: MountingHole; MountingHole_3.2mm_M3
J1: 8P8C_Shielded; RJ45_RCH_RC01937
J2: Power; JST_VH_S2P-VH_1x02_P3.96mm_Horizontal
J4, J8: AUART1; JST_XH_S4B-XH-A-1_1x04_P2.50mm_Horizontal
J5, J6, J7: JSTVH3; JST_VH_S3P-VH_1x03_P3.96mm_Horizontal
J10, J11: ADC1; JST_XH_S3B-XH-A-1_1x03_P2.50mm_Horizontal
J12: ADC1; JST_EH_S3B-EH_1x03_P2.50mm_Horizontal; not fitted
J13, J14, J15: Conn_01x02_Pin; JST_XH_S2B-XH-A-1_1x02_P2.50mm_Horizontal
JP1, JP3, JP4: VSEL; PinHeader_1x03_P2.00mm_Vertical
JP2, JP6, JP9: RS; PinHeader_1x03_P2.00mm_Vertical
K3, K4, K5: IM02; RELAY_IM06TS
PSU1: 12v-5v_mini_buck; mini12v-5v_buck
Q1, Q2, Q3: AO3400A; SOT-23
R1, R3, R5: 120; R_1206_3216Metric_Pad1.30x1.75mm_HandSolder
R2, R4, R6: 10K; R_1206_3216Metric_Pad1.30x1.75mm_HandSolder
R7, R21, R23: 2.2K; R_1206_3216Metric_Pad1.30x1.75mm_HandSolder
R8, R22, R24: 10k; R_1206_3216Metric_Pad1.30x1.75mm_HandSolder
R13, R15: 22K; R_1206_3216Metric_Pad1.30x1.75mm_HandSolder
R14, R16: 33K; R_1206_3216Metric_Pad1.30x1.75mm_HandSolder
R17: 22K; R_0603_1608Metric_Pad0.98x0.95mm_HandSolder; not fitted
R18: 33K; R_0603_1608Metric_Pad0.98x0.95mm_HandSolder; not fitted
R19, R25, R27: 100; R_1206_3216Metric_Pad1.30x1.75mm_HandSolder
R20, R26, R28: 47K; R_1206_3216Metric_Pad1.30x1.75mm_HandSolder
RS1, RS2, RS3: RS; SolderJumper-2_P1.3mm_Open_TrianglePad1.0x1.5mm
SW1: REBOOT; SW_Push_1P1T_NO_CK_KMR2
SW2, SW3, SW4: JS202011CQN
TERM1, TERM2, TERM3: TERM; SolderJumper-2_P1.3mm_Open_TrianglePad1.0x1.5mm
U1, U7, U8: LTV-357T; SOP-4_3.8x4.1mm_P2.54mm
U2: ESP32-C3_SUPERMINI_TH; MODULE_ESP32-C3_SUPERMINI_TH
U3, U4, U5: SN65HVD233DR; SOIC127P599X175-8N
U6: Teensy4.1; Teensy41

Connections:
5V_SIG1: J10.2, R13.1
5V_SIG2: J11.2, R15.1
12V_SELECT_INPUT1: J13.1, SW2.3 (C), SW2.4 (A)
12V_SELECT_INPUT2: J14.1, SW3.3 (C), SW3.4 (A)
12V_SELECT_INPUT3: J15.1, SW4.3 (C), SW4.4 (A)
+3.3V: D7.2 (K), D13.2 (K), D14.2 (K), JP2.3 (B), JP6.3 (B), JP9.3 (B), R8.2, R22.2, R24.2, U2.3.3 (3V3), U3.3 (VCC), U4.3 (VCC), U5.3 (VCC), U6.46 (3V3)
+5V: C3.1, C4.1, C5.1, D8.1 (K), D11.1 (K), D12.1 (K), D15.2 (A), D16.2 (A), J4.1, J8.1, J10.1, J11.1, J12.1, K3.1, K4.1, K5.1, PSU1.5v+ (Pin_4)
+12V: J2.1, JP1.1 (A), JP3.1 (A), JP4.1 (A), PSU1.12v+ (Pin_1), SW2.1 (A), SW3.1 (A), SW4.1 (A)
ADC1: C2.1, D7.3 (COM), R13.2, R14.1, U6.37 (15_A1_RX3_SPDIF_IN)
ADC2: C6.1, D13.3 (COM), R15.2, R16.1, U6.36 (14_A0_TX3_SPDIF_OUT)
ADC3: C7.1, D14.3 (COM), R17.2, R18.1, U6.33 (41_A17)
ARX1: J4.2, U6.20 (28_RX7)
ARX2: J8.2, U6.17 (25_A11_RX6_SDA2)
ATX1: J4.3, U6.21 (29_TX7)
ATX2: J8.3, U6.16 (24_A10_TX6_SCL2)
CAN1_H: D1.2, J1.7, TERM1.2 (B), U3.7 (CANH)
CAN1_L: D1.1, J1.8, R1.2, U3.6 (CANL)
CAN1_RX: U3.4 (RXD), U6.45 (23_A9_CRX1_MCLK1)
CAN1_TX: U3.1 (TXD), U6.44 (22_A8_CTX1)
CAN2_H: D2.2, J1.5, TERM2.2 (B), U4.7 (CANH)
CAN2_L: D2.1, J1.6, R3.2, U4.6 (CANL)
CAN2_RX: U4.4 (RXD), U6.2 (0_RX1_CRX2_CS1)
CAN2_TX: U4.1 (TXD), U6.3 (1_TX1_CTX2_MISO1)
CAN3_H: D3.2, J1.3, TERM3.2 (B), U5.7 (CANH)
CAN3_L: D3.1, J1.4, R5.2, U5.6 (CANL)
CAN3_RX: U5.4 (RXD), U6.22 (30_CRX3)
CAN3_TX: U5.1 (TXD), U6.23 (31_CTX3)
GND: C2.2, C6.2, C7.2, D1.3, D2.3, D3.3, D7.1 (A), D13.1 (A), D14.1 (A), J1.2, J1.SH, J2.2, J4.4, J8.4, J10.3, J11.3, J12.3, JP1.3 (B), JP3.3 (B), JP4.3 (B), PSU1.5v- (Pin_3), PSU1.12v- (Pin_2), Q1.2 (S), Q2.2 (S), Q3.2 (S), R2.1, R4.1, R6.1, R14.2, R16.2, R18.2, R20.2, R26.2, R28.2, RS1.2 (B), RS2.2 (B), RS3.2 (B), SW1.2, SW2.6 (C), SW3.6 (C), SW4.6 (C), U1.3, U2.G (GND), U3.2 (GND), U4.2 (GND), U5.2 (GND), U6.1 (GND), U6.34 (GND), U6.47 (GND), U6.52 (GND), U6.58 (GND), U6.59 (GND), U7.3, U8.3
GPIO_IN1: R8.1, U1.4, U6.4 (2_OUT2)
GPIO_IN2: R22.1, U6.5 (3_LRCLK2), U7.4
GPIO_IN3: R24.1, U6.6 (4_BCLK2), U8.4
GPIO_OUT1: R19.1, R20.1, U6.14 (12_MISO_MQSL)
GPIO_OUT2: R25.1, R26.1, U6.18 (26_A12_MOSI1)
GPIO_OUT3: R27.1, R28.1, U6.19 (27_A13_SCK1)
unnamed: D5.2 (A), SW2.5 (B), U1.2
unnamed: D5.1 (K), R7.2, U1.1
unnamed: C3.2, D8.2 (A), K3.8, Q1.3 (D)
unnamed: D9.2 (A), SW3.5 (B), U7.2
unnamed: D9.1 (K), R21.2, U7.1
unnamed: D10.2 (A), SW4.5 (B), U8.2
unnamed: D10.1 (K), R23.2, U8.1
unnamed: C4.2, D11.2 (A), K4.8, Q2.3 (D)
unnamed: C5.2, D12.2 (A), K5.8, Q3.3 (D)
unnamed: D15.1 (K), U6.48 (VIN)
unnamed: D16.1 (K), U2.5V
unnamed: J5.1, K4.7
unnamed: J5.2, K4.6
unnamed: J5.3, K4.5
unnamed: J6.1, K5.7
unnamed: J6.2, K5.6
unnamed: J6.3, K5.5
unnamed: J7.1, K3.7
unnamed: J7.2, K3.6
unnamed: J7.3, K3.5
unnamed: J12.2, R17.1
unnamed: J13.2, JP1.2 (C)
unnamed: J14.2, JP3.2 (C)
unnamed: J15.2, JP4.2 (C)
unnamed: JP2.1 (A), R2.2, RS1.1 (A)
unnamed: JP2.2 (C), U3.8 (RS)
unnamed: JP6.1 (A), R4.2, RS2.1 (A)
unnamed: JP6.2 (C), U4.8 (RS)
unnamed: JP9.1 (A), R6.2, RS3.1 (A)
unnamed: JP9.2 (C), U5.8 (RS)
unnamed: Q1.1 (G), R19.2
unnamed: Q2.1 (G), R25.2
unnamed: Q3.1 (G), R27.2
unnamed: R7.1, SW2.2 (B)
unnamed: R21.1, SW3.2 (B)
unnamed: R23.1, SW4.2 (B)
unnamed: R1.1, TERM1.1 (A)
unnamed: R3.1, TERM2.1 (A)
unnamed: R5.1, TERM3.1 (A)
unnamed: SW1.1, U6.25 (33_MCLK2)
T_RX->E_TX: U2.2 (GPIO1), U6.9 (7_RX2_OUT1A)
T_TX->E_RX: U2.3 (GPIO2), U6.10 (8_TX2_IN1)

Notes on the sheet:
AUX UART
Power
CAN1
TODO V2: - rewire RJ45 so pairs are together and same sequence - replace SN65HVD233DR with FdCAN capable chips - add fuse - add reboot button
CAN
12V Selectable Input
5V ADC
CAN2
12V Relay Output
high speed: JP 2->1 and solder RS slope control: JP 2->1 and open RS low power mode: JP 2->3
ESP32/WiFi
Teensy 4.1

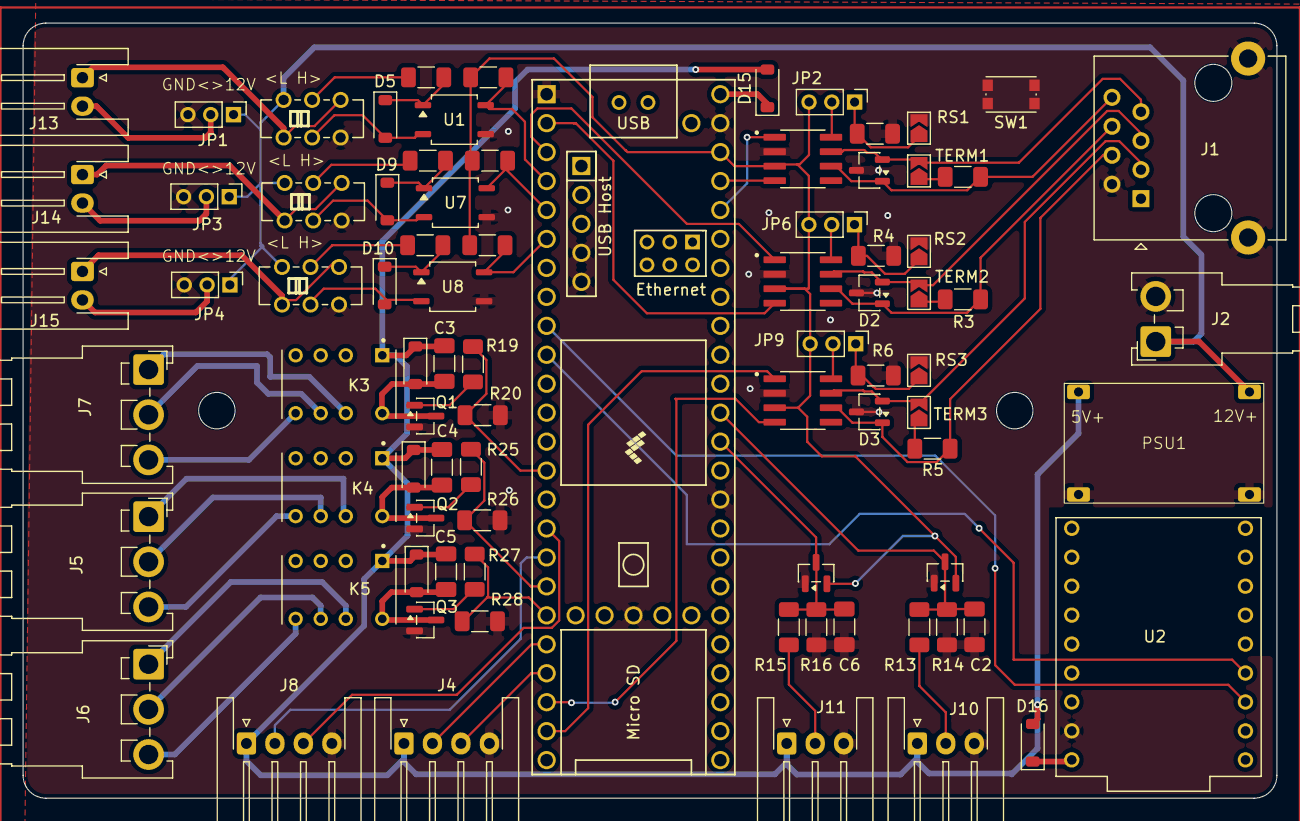
[picture p16: board CarCANdy-PCB.kicad_pcb from above]

Board: 2 copper layers, 110.0 x 68.0 mm, 85 parts (0 on the bottom side), 74 nets.
