redt1de/CarCANdy/Firmware/Teensy/src/ConfigManager.cpp

#include "ConfigManager.h"
#include "Logging.h"
#include <SD.h>

namespace {
constexpr const char *kConfigPath = "/config.json";
}

bool ConfigManager::begin() {
  // logFile_/debugFile_ aren't open yet this early in boot (logging.begin()
  // hasn't run), so this is a no-op in practice -- kept for safety in case
  // that ordering ever changes. See Logging.h for why this is required.
  LoggingPause pause(logging);

  if (!SD.begin(BUILTIN_SDCARD)) {
    Serial.println("[Config] SD card not available, using defaults");
    loadDefaults();
    return false;
  }

  File f = SD.open(kConfigPath, FILE_READ);
  if (!f) {
    Serial.println("[Config] /config.json not found, using defaults");
    loadDefaults();
    return false;
  }

  DeserializationError err = deserializeJson(doc_, f);
  f.close();
  if (err) {
    Serial.print("[Config] parse failed: ");
    Serial.println(err.c_str());
    loadDefaults();
    return false;
  }

  return true;
}

bool ConfigManager::save() {
  // See Logging.h -- logFile_/debugFile_ must be closed while we touch
  // config.json, or writes here have been observed to corrupt either file.
  LoggingPause pause(logging);

  if (!SD.begin(BUILTIN_SDCARD)) {
    Serial.println("[Config] save() failed: SD card not available");
    return false;
  }
  if (SD.exists(kConfigPath)) {
    SD.remove(kConfigPath);
  }
  File f = SD.open(kConfigPath, FILE_WRITE);
  if (!f) {
    Serial.println(
        "[Config] save() failed: could not open /config.json for writing");
    return false;
  }
  serializeJson(doc_, f);
  f.close();
  return true;
}

bool ConfigManager::applyJson(const uint8_t *data, size_t len) {
  JsonDocument newDoc;
  DeserializationError err = deserializeJson(newDoc, data, len);
  if (err) {
    Serial.print("[Config] applyJson() parse failed: ");
    Serial.println(err.c_str());
    return false;
  }
  doc_ = newDoc;
  return save();
}

size_t ConfigManager::toJson(char *outBuf, size_t outBufLen) const {
  const size_t n = serializeJson(doc_, outBuf, outBufLen);
  // serializeJson() stops early if the buffer is too small; treat filling
  // the whole buffer as a truncation signal rather than a clean fit.
  return n >= outBufLen ? 0 : n;
}

void ConfigManager::loadDefaults() {
  doc_.clear();
  doc_["commMode"] = "UART";

  JsonArray buses = doc_["canBuses"].to<JsonArray>();
  struct {
    uint8_t id;
    bool enabled;
    uint32_t baud;
    const char *mode;
  } defaults[] = {
      {1, true, 500000, "read_only"},
      {2, true, 500000, "read_only"},
      {3, false, 500000, "read_only"},
  };
  for (auto &d : defaults) {
    JsonObject b = buses.add<JsonObject>();
    b["id"] = d.id;
    b["enabled"] = d.enabled;
    b["baud"] = d.baud;
    b["mode"] = d.mode;
  }

  JsonObject logging = doc_["logging"].to<JsonObject>();
  logging["toSerial"] = true;
  logging["toSD"] = true;
  logging["toComm"] = true;
  logging["prefix"] = "canlog";

  // "none" by default so upgrading firmware never silently hides traffic
  // that used to be visible -- filtering is opt-in.
  JsonObject filters = doc_["filters"].to<JsonObject>();
  filters["mode"] = "none";
  filters["file"] = "/filters.csv";

  doc_["debug"] = false;
  doc_["simulate"] = false;

  // No plugin defaults here -- PluginManager::begin() seeds doc_["plugins"]
  // from each registered plugin's own setDefaultConfig() right after this
  // runs (or after a successful SD load), via pluginDefaultsTarget() below.
}

const char *ConfigManager::commMode() const {
  return doc_["commMode"] | "UART";
}

const char *ConfigManager::loggingPrefix() const {
  return doc_["logging"]["prefix"] | "canlog";
}

const char *ConfigManager::filterMode() const {
  return doc_["filters"]["mode"] | "none";
}

const char *ConfigManager::filterFile() const {
  return doc_["filters"]["file"] | "/filters.csv";
}

bool ConfigManager::debugEnabled() const {
  return doc_["debug"] | false;
}

bool ConfigManager::simulateEnabled() const {
  return doc_["simulate"] | false;
}

ConfigManager::CanBusConfig ConfigManager::canBus(uint8_t busNumber) const {
  JsonArrayConst buses = doc_["canBuses"];
  for (JsonObjectConst b : buses) {
    if ((b["id"] | 0) == busNumber) {
      return CanBusConfig{
          busNumber,
          b["enabled"] | false,
          b["baud"] | 500000u,
          b["mode"] | "read_only",
      };
    }
  }
  // No matching entry -- disabled by default rather than guessing a baud.
  return CanBusConfig{busNumber, false, 500000u, "read_only"};
}

bool ConfigManager::isPluginEnabled(const char *name) const {
  return doc_["plugins"][name]["enabled"] | false;
}

JsonObjectConst ConfigManager::pluginConfig(const char *name) const {
  return doc_["plugins"][name]["config"];
}

JsonObject ConfigManager::pluginDefaultsTarget(const char *name, bool enabledDefault) {
  JsonVariant pluginsSlot = doc_["plugins"];
  JsonObject plugins = pluginsSlot.is<JsonObject>() ? pluginsSlot.as<JsonObject>() : pluginsSlot.to<JsonObject>();

  JsonVariant pluginSlot = plugins[name];
  JsonObject plugin = pluginSlot.is<JsonObject>() ? pluginSlot.as<JsonObject>() : pluginSlot.to<JsonObject>();

  if (plugin["enabled"].isNull()) {
    plugin["enabled"] = enabledDefault;
  }

  JsonVariant cfgSlot = plugin["config"];
  return cfgSlot.is<JsonObject>() ? cfgSlot.as<JsonObject>() : cfgSlot.to<JsonObject>();
}
