redt1de/CarCANdy/Firmware/ESP32/src/SPIClient.cpp

#include "SPIClient.h"

bool SPIClient::begin() {
    Serial.println("[SPIClient] SPI master mode not yet implemented -- see DOC/open-risks.md #1");
    return false;
}

bool SPIClient::available() {
    return false;
}

bool SPIClient::sendPacket(const CarCANdy::Packet&) {
    return false;
}

bool SPIClient::readPacket(CarCANdy::Packet&) {
    return false;
}

void SPIClient::poll() {
    // no-op stub -- future: check DRDY GPIO, initiate SPI transfer if high.
}
