redt1de/CarCANdy/ESP32/include/UARTClient.h

#pragma once
#include <Arduino.h>
#include "CommClient.h"

// CommClient implementation over a hardware UART -- the physical link to
// the Teensy when running in UART mode. Which UART object and which pins
// is board-specific (e.g. Serial2/GPIO16+17 on the classic ESP32, vs
// Serial0/GPIO43+44 on the ESP32-S3-Mini), so it's selected per
// PlatformIO environment via the CARCANDY_UART_PORT/RX_PIN/TX_PIN build
// flags (see ESP32/platformio.ini) rather than hardcoded here -- swapping
// boards means editing platformio.ini, not this file. Whichever UART is
// selected is used exclusively for this link; all debug/status output
// goes over the default USB Serial instead (see Logging), since mixing
// plain-text debug prints into this stream would corrupt the binary
// packet framing. Feeds incoming bytes through a
// CarCANdy::PacketStreamParser (see Shared/Packet.h) so sync-byte
// collisions with real CAN payload data don't corrupt the stream, and
// queues completed packets so a burst of several packets between poll()
// calls isn't silently dropped. Mirrors Teensy/src/UARTClient.
class UARTClient : public CarCANdy::CommClient {
public:
    bool begin() override;
    bool available() override;
    bool sendPacket(const CarCANdy::Packet& pkt) override;
    bool readPacket(CarCANdy::Packet& outPkt) override;
    void poll() override;

private:
    static constexpr uint8_t kQueueSize = 8;

    CarCANdy::PacketStreamParser parser_;
    CarCANdy::Packet queue_[kQueueSize];
    uint8_t queueHead_ = 0;
    uint8_t queueCount_ = 0;
};
