redt1de/CarCANdy/(commit log)

2026-07-11 added support for ESP32-S3-Mini (HW Serial)
2026-07-11 started pcb
2026-07-12 implemented filtering (untested), added tmux build script, started PCB
2026-07-17 added to PCB
2026-08-04 added aux ports header to teensy
2026-08-25 bug fixes in PCB
2026-08-25 added diodes to power rails, rewired RJ45
2026-10-18 Remove stale top-level PCB/README paths superseded by Hardware/ move
    CarCANdy-PCB/, CarCANdy-PCB-v2/, and README.md were moved into Hardware/
    by hand rather than via git mv, so their old paths were never actually
    removed from the index -- every file here already has an identical
    counterpart under Hardware/ (verified by blob hash). Also includes the
    pending .gitignore update (Firmware/Hardware path fixes, KiCad .history
    ignore) and a trivial KiCad designator-list reorder in
    CarCANdy-PCB.kicad_pro.
2026-10-18 Remove tracked KiCad lock files, ignore them going forward
    ~*.lck files are KiCad's per-machine "who has this open" markers, not
    project content -- they'd already gone stale (deleted on disk once KiCad
    released them) and were just sitting as unstaged deletions.
